IvanMoyaO/SQUAWK-GAL/Informe/include/pkgs.tex

% ============
% IDIOMA
% ============
\usepackage[utf8]{inputenc}  % usar utf8
\usepackage[spanish]{babel}
\decimalpoint % Usar punto decimal

% ============
% ESPACIADO
% ============
\usepackage{setspace} 
\setstretch{1.2}
% sangría
\usepackage{indentfirst}
\setlength{\parskip}{0.5cm}       
\setlength{\parindent}{0.7cm}

% ============
% MATEMÁTICAS
% ============
\usepackage{amsmath}
\usepackage{amssymb}
\usepackage{mathtools}

% ============
% APARIENCIA
% ============
\usepackage{fontawesome5} % Simbolitos (es font-awesome 5)
\usepackage{bigints} % integrales bonitas
\usepackage{xcolor} % colores
\usepackage{graphicx} 
\usepackage[most]{tcolorbox} % cajitas
\usepackage{fancyhdr} % ver page_style (\pagestyle{fancy})

\usepackage[paper=A4]{typearea} % Márgenes
\usepackage[top=3cm, bottom=3cm,
            left = 1.5cm, right = 1.5cm,
            headsep = 1cm, 
            ignoremp]{geometry}
            
% ============
% MISC
% ============
\usepackage{hyperref} % índice clickable

\usepackage{caption}
\usepackage{subcaption}

\usepackage{wrapfig,lipsum}

\usepackage{cleveref}
