IvanMoyaO/SQUAWK-GAL/Informe/include/title.tex

\begin{titlepage}
    \begin{center}
    
    % Logo ETSIAE
        \begin{figure}[!htb]
            \centering
            
        \end{figure}
        \rule{\linewidth}{0.3mm}\\
    % ============

    % Zona del título 
        \vspace*{0.4cm}    
        \begin{large}
          \textsc{Prácticas de Laboratorio}
        \end{large}
    
        \vspace*{0.1cm}
        \begin{Large}
          \textbf{\Subject}
        \end{Large}
        
        \vspace*{0.1cm}
        \begin{large}
          \underline{\textsc{\Lab}}
        \end{large}

        \rule{\linewidth}{0.3mm}\\  
    % ============

    % Zona del grado y especialidad      
        \vspace*{1cm}
        \begin{small}
            \textbf{ \Degree } \\
            \Especiality
        \end{small}
    % ============

    \vspace*{2cm}

    \textit{\textbf{Autores}}: \linebreak \textsc{\Author}

    % Zona de la parte inferior
        \vspace*{3cm}
        \begin{large}
            \textsc{\Location - \today}
		\end{large}
   % ============
    \end{center}
\end{titlepage}
