IvanMoyaO/SQUAWK-GAL/Informe/main.tex

\documentclass[12pt,a4paper,titlepage,twoside]{report}

% ============
% CONFIGURACIÓN
% vvvvvvvvvvvv
  
  \newcommand{\Subject}{ Tratamiento Digital de la Información } % Lo que va debajo de "Prácticas de Laboratorio" en la portada, y a arriba a la derecha en todas las hojas

   \newcommand{\Lab}{ Generador de Códigos SQUAWK } % Abajo de nombre asign
  
  \newcommand{\Degree}{ Ingeniería Aeroespacial } % Lo que va debajo de los títulos en la portada  
  \newcommand{\Especiality}{ Navegación y Sistemas Aeroespaciales } % Debajo del grado

  \newcommand{\Author}{ Alves Guerra de Saude Candeias, Mariana \linebreak Moya Ortiz, Iván \linebreak Paz Díez, Juan Manuel \linebreak Ramírez Moreira, Valeri Paola } % Lo que va encima de la fecha
  \newcommand{\Location}{ Madrid } % Lo que acompaña a la fecha
% ^^^^^^^^^^^^

% ============
% ARCHIVOS DE CONFIGURACIÓN
% ============
\input{include/pkgs}
\input{include/page_style}
\input{include/boxes}
\input{include/math_symbols}
% ========================
\begin{document}

\input{include/title}

\setcounter{page}{0}
\pagenumbering{arabic}

\input{contents/contenido}

% ============
\end{document}
