IvanMoyaO/SQUAWK-GAL/Informe/include/page_style.tex

\pagestyle{fancy} % Estilo general
\fancyhf{}  % Para que la numeración no esté en el centro

% ============
% Header
% ============
\lhead{\begin{large}{ Prácticas TDI }\end{large}}
\rhead{\begin{large}{ \Lab }\end{large}}

\fancyheadoffset[rh]{0pt}
\fancyfootoffset[rh]{0pt}

% ============
% Footer
% ============
\fancyfoot[RO]{\thepage}
\fancyfoot[LE]{\thepage}
