IvanMoyaO/SQUAWK-GAL/Informe/include/figures/esquema.pdf

## OSCILADOR

## 1 BARRA 1

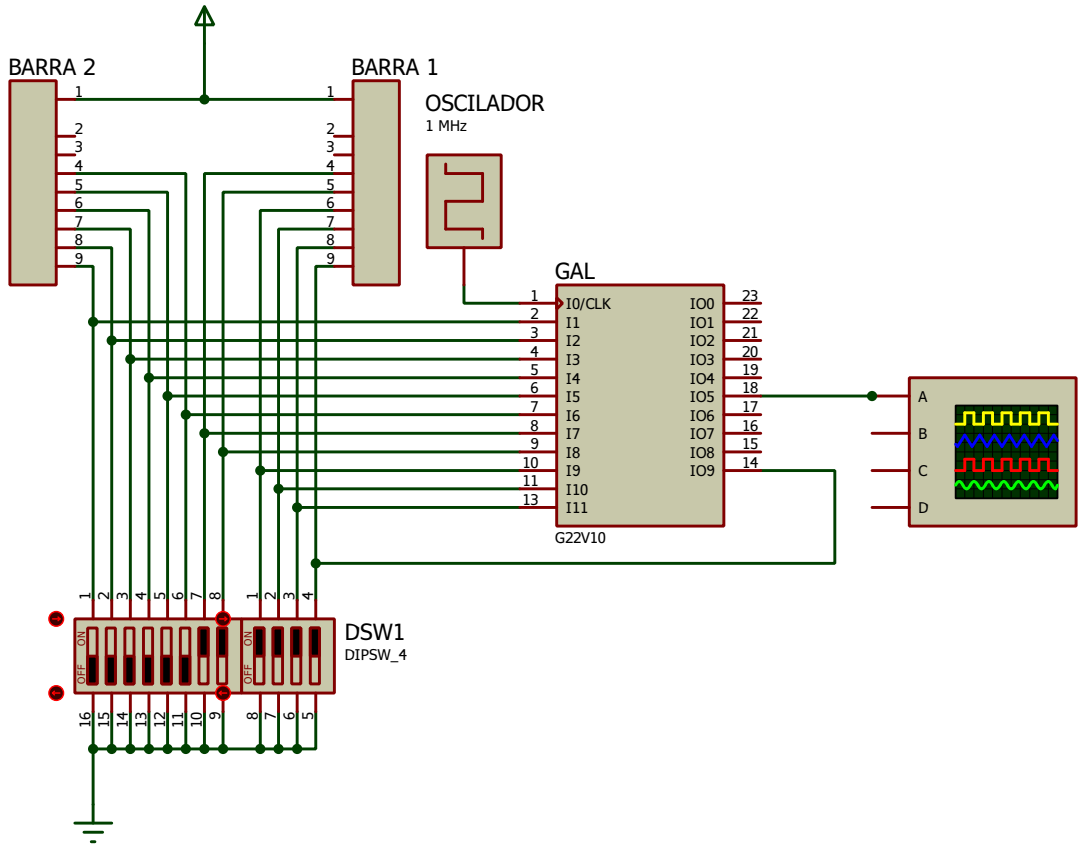
[picture p5: page 1]
I0/CLK; GAL; 1 MHz 3; 1 BARRA 2; OFF ON 1; 5 DSW1; DIPSW_4; BCD
