IvanMoyaO/SQUAWK-GAL/circuito.PDF

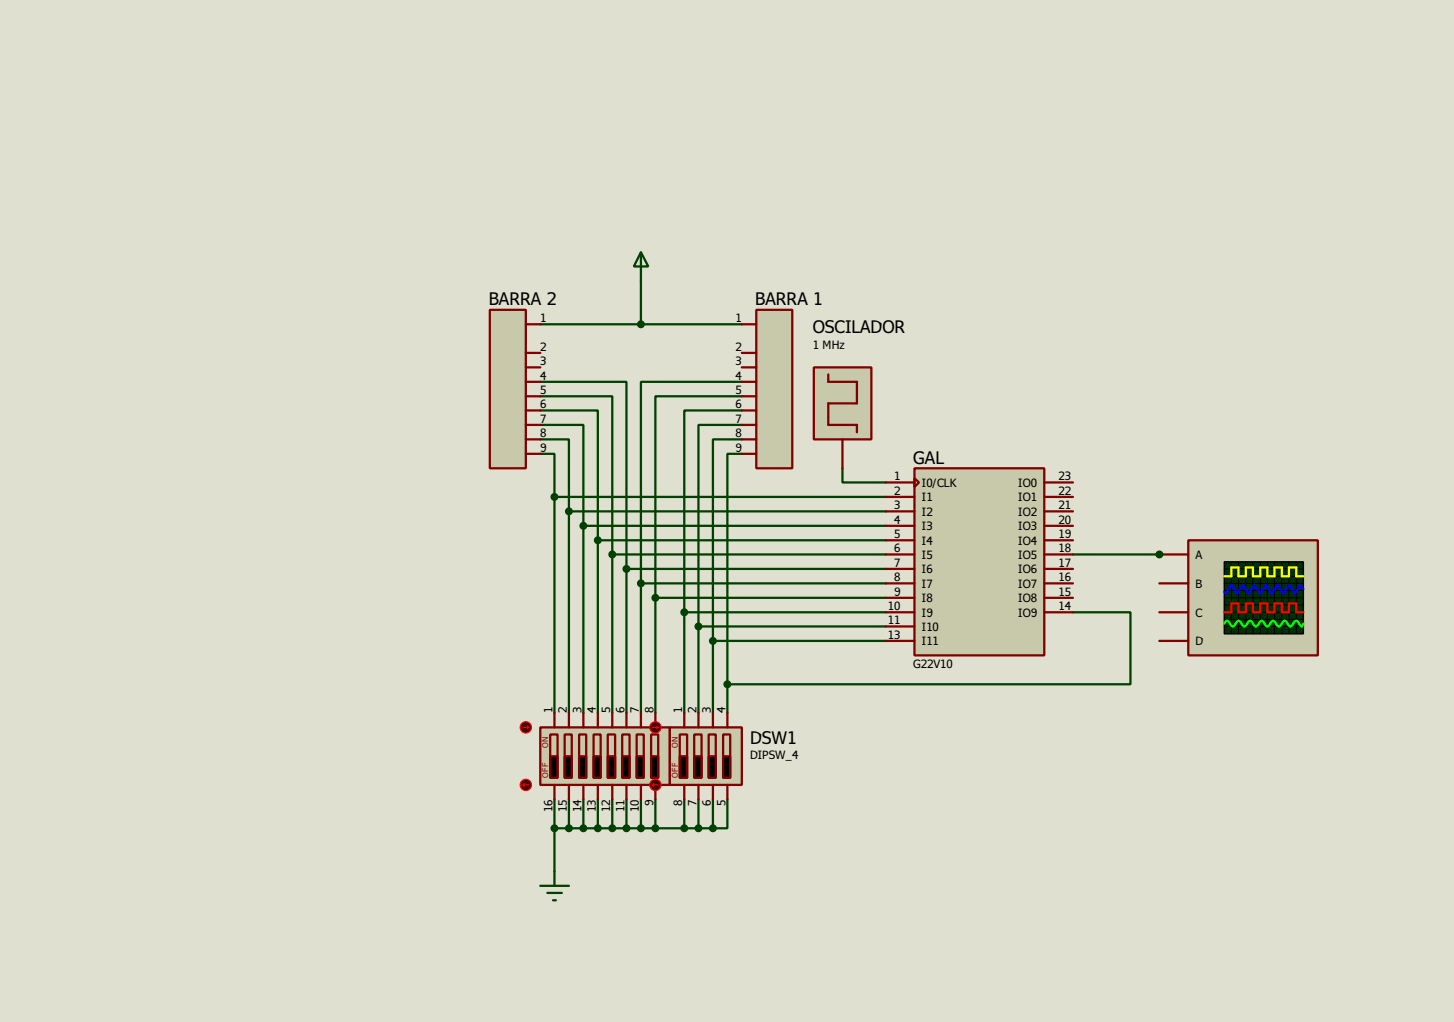
[picture p6: page 1]
