IvanMoyaO/SQUAWK-GAL/(list of files, drawings)

Other design files:
circuito.pdsprj
